mapettar/OGN-Solar-Receiver/images/rpi-gpio-pinout.png

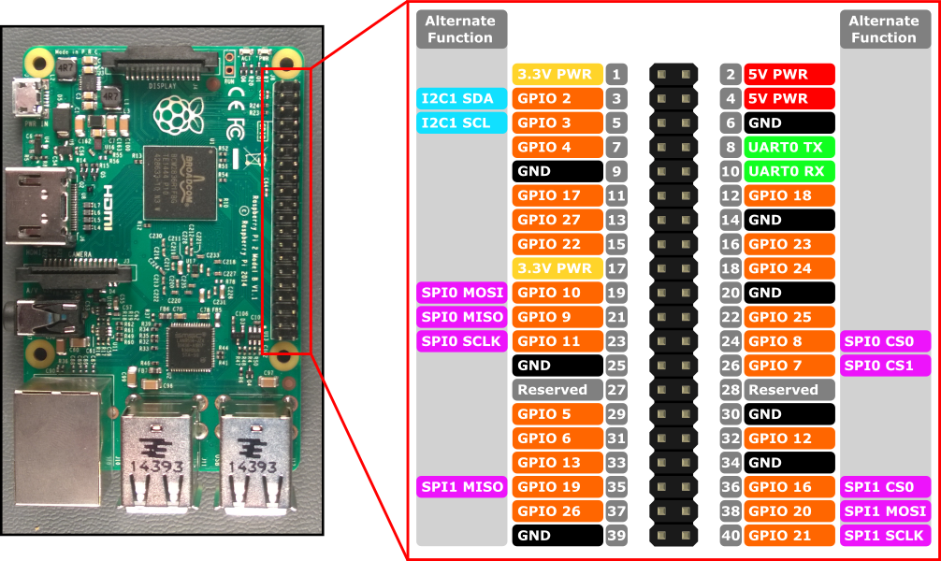
images/rpi-gpio-pinout.png
