mapettar/OGN-Solar-Receiver/src/README.md

# Sorgenti

| Percorso | Dove va | Note |
|---|---|---|
| `attiny/OGN_Attiny_v1_7_3/OGN_Attiny_v1_7_3.ino` | ATtiny85 Digispark (Arduino IDE) | Come la 1.7.2, ma negli ultimi 3 minuti prima del taglio non legge il DS3231 (SCL a massa sveglia la RPi in halt). Da usare con `SCHEDULE=on` (halt a tramonto-90, taglio a tramonto-88) |
| `attiny/OGN_Attiny_v1_7_2/OGN_Attiny_v1_7_2.ino` | ATtiny85 Digispark (Arduino IDE) | Soglie batteria per Li-ion 3S (R1 56k / R2 10k). Per LiFePO4 2S con partitore 20k/10k: `SOGLIA_BATT_MIN 310`, `SOGLIA_BATT_ON 330` |
| `rpi-boot/calc_sunset.py` | `/boot/` sulla RPi | Tramonto, crontab e taglio relè (tetto 19:00 CEST) |
| `rpi-boot/setup_cron.sh` | `/boot/` sulla RPi | Eseguito ad ogni avvio. Imposta `TS_AUTHKEY` con la TUA chiave Tailscale e **non pubblicarla** |
| `rpi-boot/monitor_batteria.py` | `/boot/` sulla RPi | Lettura INA219 (pacco 3S, librerie Adafruit) |
| `rpi-bookworm/ogn-boot-setup.sh` + `.service` | `/usr/local/sbin/` e `/etc/systemd/system/` | Raspberry Pi 3A+ con Bookworm: scrive l'ora sul DS3231 dopo la sincronizzazione e (con `SCHEDULE=on` in `/etc/default/ogn-boot-setup`) imposta lo spegnimento serale |
| `rpi-bookworm/calc_sunset.py` | `/usr/local/sbin/` | Come `rpi-boot/calc_sunset.py` |
| `rpi-bookworm/monitor_batteria.py` | `/usr/local/sbin/` | Lettura INA219 senza librerie (v1.9). Profili `2s-lifepo4` (default) e `3s-liion` con `--pacco`; `--csv` per i log; `--addr 0x41 --carica` per il secondo INA219 in serie al caricabatterie (corrente positiva = entra nel pacco) |
| `rpi-bookworm/install.sh` | scaricato ed eseguito con `sudo` | Installa tutti gli script qui sotto, il comando `stato`, i cron, la rotazione dei log e il journal persistente (v1.6; `--hw-watchdog on` attiva anche il watchdog hardware del chip). Presuppone rtlsdr-ogn già funzionante. Provato su una Zero 2 W con SD nuova |
| `rpi-bookworm/stato_stazione.sh` (comando `stato`) | `/usr/local/sbin/` | Riepilogo mattutino con `[OK]`/`[!!]`: avvio, **rete (indirizzo locale e Tailscale)**, DS3231, ciclo spegnimento/avvio, servizi OGN, **chiavetta RTL-SDR, tentativi falliti e CPU di `ogn-rf`, rete APRS**, alimentazione, batteria, **carica (secondo INA219)**, BME280, disco (v1.13) |
| `rpi-bookworm/stato_web.py` + `ogn-stato-web.service` | `/usr/local/sbin/` e `/etc/systemd/system/` | Opzionali (`install.sh --web on`): pagina HTML con il riepilogo di `stato` sulla porta 8090, solo rete locale/Tailscale |
| `rpi-bookworm/ogn_sim.py` + `ogn-sim.service` | `/usr/local/sbin/` e `/etc/systemd/system/` | Opzionali (`install.sh --sim auto|always`): collegamento a internet via SIM7080G con PPP (accensione del modulo, registrazione LTE-M, `pppd`, ripresa se cade, SIM solo se manca il Wi-Fi); impostazioni in `/etc/default/ogn-sim`; richiede `ppp` e `python3-serial` |
| `rpi-bookworm/sim_at.py` | a mano (non installato) | Strumento per comandi AT al modulo SIM7080G a servizio fermato: diagnosi, comandi liberi, `--segnale` per confrontare le antenne |
| `rpi-bookworm/ogn-rtc-ora.sh` + `.service` | `/usr/local/sbin/` e `/etc/systemd/system/` | Raspberry Pi con DS3231: all'avvio, prima della rete e di `ogn-sim`, mette l'ora del DS3231 nell'orologio di sistema (l'orologio di `fake-hwclock` e' in ritardo di ore). Non fa niente se NTP ha gia' sincronizzato, se il DS3231 manca (Zero 2 W) o ha perso l'ora. Evento `ora dal DS3231` in `ogn-eventi.log` |
| `rpi-bookworm/ogn-usb-watchdog.sh` | `/usr/local/sbin/` | Opzionale (`install.sh --watchdog prova|on`): riavvia la Pi se la chiavetta RTL-SDR manca, o solo i servizi OGN se `ogn-rf` è inattivo; impostazione `WATCHDOG_USB=off|prova|on` in `/etc/default/ogn-boot-setup`; stato v1.9 conta i riavvii |
| `rpi-bookworm/bme280_log.py` | `/usr/local/sbin/` | Temperatura, umidità, pressione e punto di rugiada della scatola in `/boot/bme280.log`; avviso in `ogn-eventi.log` a umidità ≥ 80 % |
| `rpi-bookworm/ds3231_log.sh` | `/usr/local/sbin/` | Una riga al minuto con ora e stato del DS3231 in `/var/log/ds3231.log` (cron) |

Soglie 3S: con il Digispark e il partitore 56k/10k, `SOGLIA_BATT_MIN 310` e `SOGLIA_BATT_ON 340` corrispondono a circa 10,35 V e 11,35 V (misurati; vedi `README.md` nella radice del ramo).

Procedura di installazione e ripristino per la Pi 3A+: `OGN-Comandi-SSH-3A-Bookworm.md`. Per il progetto originale (Pi 4): `OGN-Solar-Receiver-Documentazione_1.6.md` (versione 1.7) e `OGN-Comandi-SSH-Reference.md`.
