mapettar/OGN-Solar-Receiver/images/blocco-interruttore-mosfet.png

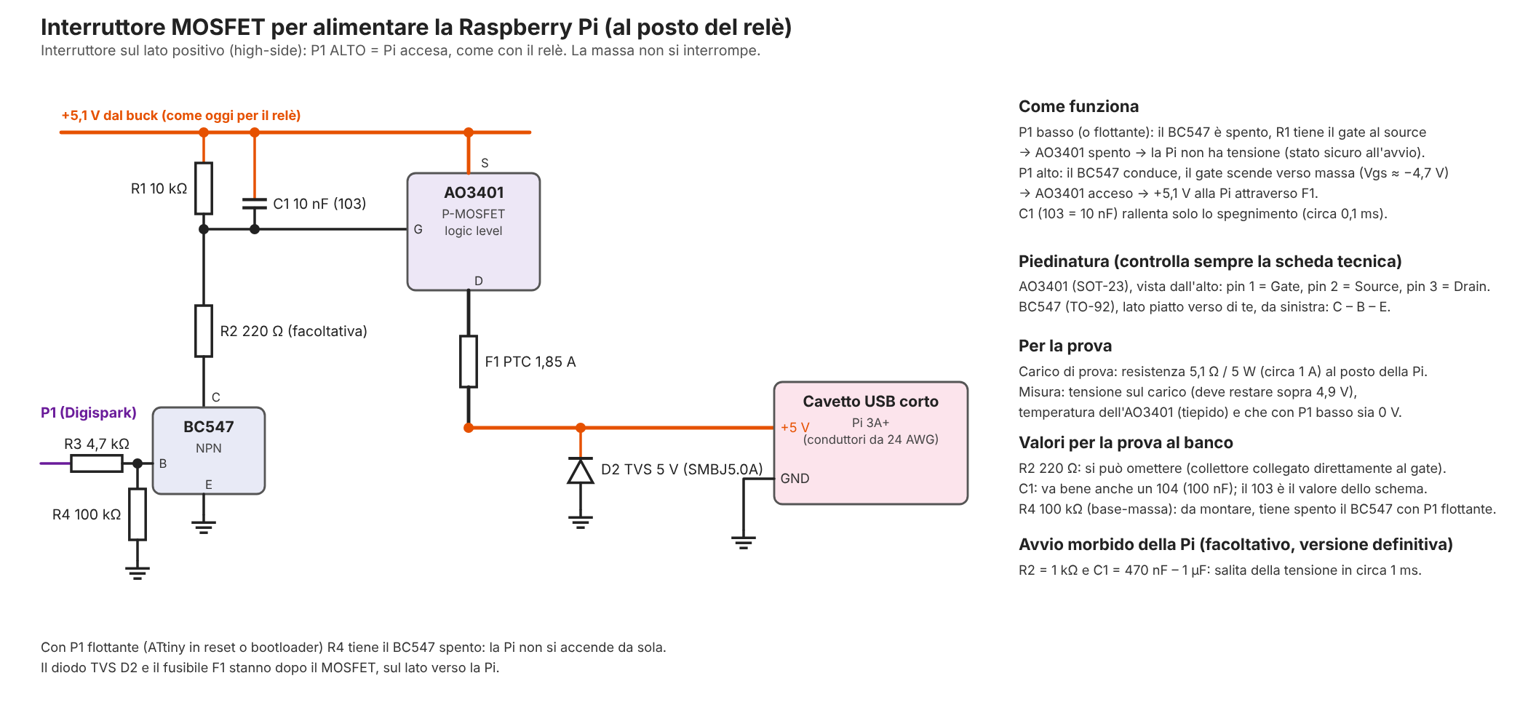
images/blocco-interruttore-mosfet.png
