mapettar/OGN-Solar-Receiver/images/schema-collegamenti-3s.png

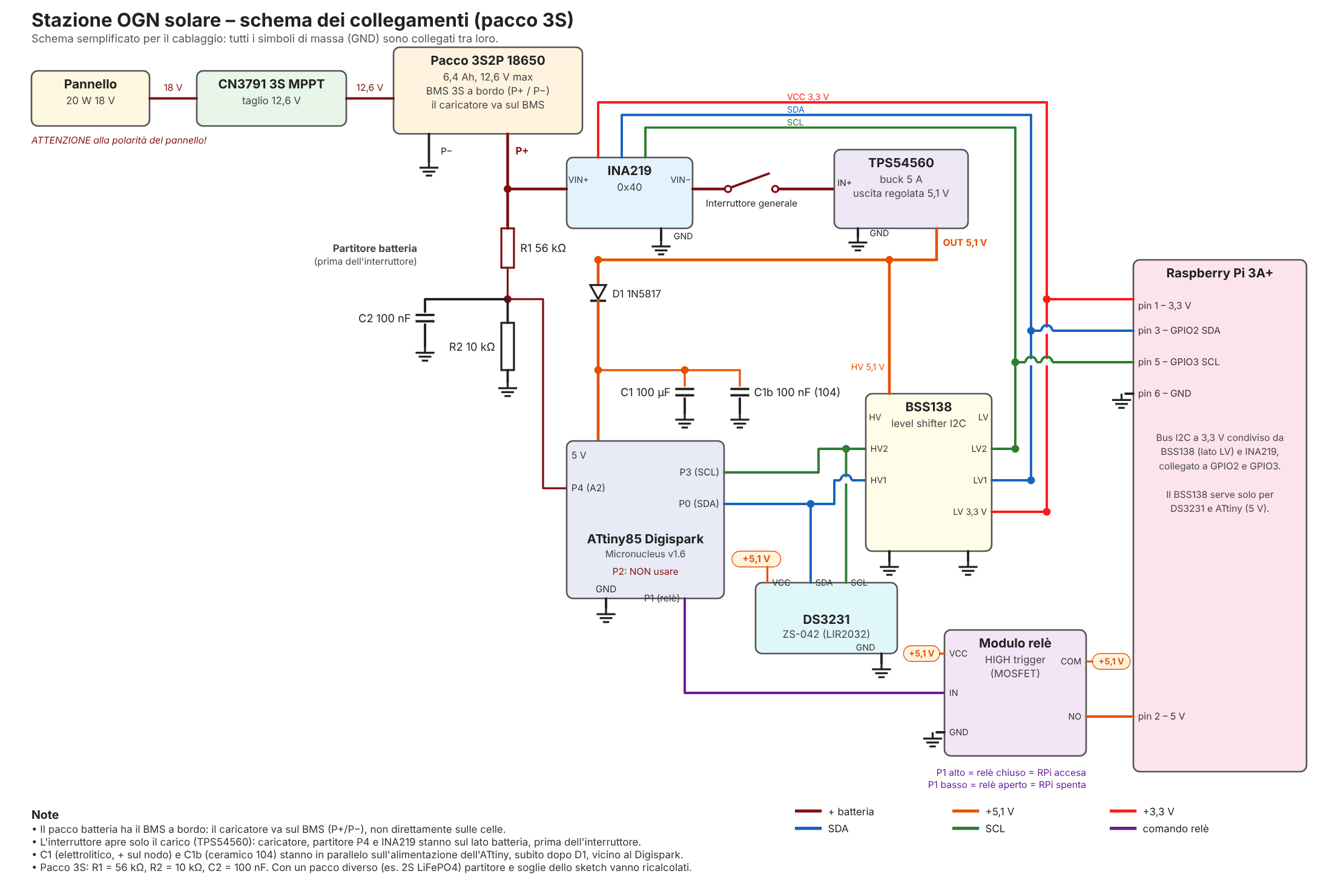
images/schema-collegamenti-3s.png
