mapettar/OGN-Solar-Receiver/(commit log)

2026-08-29 Add files via upload
    Questa guida descrive la realizzazione di una stazione ricevitore OGN (Open Glider Network) autonoma, alimentata da pannello solare e pacco batterie LiFePO4, installabile in zone remote senza rete elettrica né WiFi.
2026-10-20 Aggiunti script di avvio per Raspberry Pi 3A+ (Bookworm), da rivedere
    ogn-boot-setup.sh + .service sostituiscono setup_cron.sh sulla 3A+:
    scrivono l'ora sul DS3231 dopo la sincronizzazione e lanciano calc_sunset.py.
    Nessuna chiave Tailscale, nessuna installazione di pacchetti.
    SCHEDULE=off in /etc/default/ogn-boot-setup disattiva lo spegnimento serale.
    calc_sunset.py e' invariato rispetto a src/rpi-boot. Non ancora provati su hardware.
    Claude-Session: https://claude.ai/code/session_01PcGQ9EdoJzeQdK5e1YwwCo
2026-10-21 ATtiny v1.7.3: silenzio I2C negli ultimi 3 minuti prima del taglio
    Una RPi in halt si risveglia se SCL (GPIO3) viene tirato a massa; le letture
    del DS3231 ogni 30 s la riaccendevano dopo circa 45 s e il rele la tagliava a
    meta avvio. Ora l'ATtiny aspetta l'istante del taglio senza toccare il bus
    (protezione batteria sempre attiva) e apre il rele all'ora esatta.
    Verificato su PC con simulazione del DS3231: giornata normale, tetto 17:00 UTC,
    orologio perso, batteria bassa durante l'attesa, riavvio negli ultimi minuti.
    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
2026-10-21 monitor_batteria.py per Bookworm: INA219 senza librerie, soglie pacco 2S LiFePO4
    Legge /dev/i2c-1 direttamente (nessun pacchetto da installare), calcola la
    corrente dalla tensione sullo shunt (0.1 ohm) e stampa lo stato con soglie 2S.
    Opzione --csv per i log. README: aggiunti gli script di rpi-bookworm.
    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
2026-10-21 monitor_batteria.py: profili di pacco 2S LiFePO4 e 3S Li-ion
    Selezione con --pacco o variabile OGN_PACCO (default 2s-lifepo4), cosi lo stesso
    script serve la stazione attuale e quella con il pacco 3S.
    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
2026-10-21 Guida comandi SSH per la 3A+ con Bookworm
    Sostituisce la guida v1.7 per la nuova stazione: servizi systemd, ogn-boot-setup,
    SCHEDULE, DS3231, INA219 con profili 2S/3S, soglie ATtiny, backup immagine.
    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
2026-10-22 ogn-boot-setup v1.1: controllo di sincronizzazione vero (ntpq) al posto di NTPSynchronized
    Con ntpd attivo, timedatectl poteva dire 'synchronized: yes' con l'ora vecchia di
    fake-hwclock: lo script scriveva quell'ora sul DS3231 a ogni avvio e l'ATtiny tagliava
    il rele dopo ~2 minuti, in ciclo. Ora si scrive solo con un server scelto da ntpd
    (riga '*' in ntpq -pn) o con il file di timesyncd; altrimenti il DS3231 non si tocca.
    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
2026-10-22 Sketch di test da banco per il PCB: relè fisso, livelli SDA/SCL e lettura DS3231 con codici a lampeggi
    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
2026-10-25 Pinout GPIO Raspberry Pi nella documentazione
    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
2026-10-25 Schema e documentazione: rimossa R3 (pull-up 470 ohm), aggiunto C1b 100 nF in parallelo a C1
    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
2026-10-25 Documentazione: tolto il riferimento al pull-up 470 ohm
    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
2026-10-26 Schema: +3,3 V in rosso, +batteria in rosso scuro (non confondibile con SCL)
    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
2026-10-27 Schema del blocco interruttore MOSFET (BC547 + AO3401, PTC, TVS) al posto del relè
    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
2026-10-27 Schema interruttore MOSFET: valori corretti (C1 103/104, R2 facoltativa, avvio morbido)
    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
2026-10-29 Aggiunge bme280_log.py v1.0: log temperatura/umidita' e avviso umidita' alta
    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
2026-10-29 stato_stazione.sh v1.1: ora UTC di avvio corretta, ignora INA219 senza batteria
    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
2026-10-29 stato_stazione.sh v1.2: INA219 non collegato non stampa il traceback
    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
2026-10-31 Ramo 3A+: README, stato v1.4 con controllo della chiavetta RTL-SDR, guida aggiornata
    - README.md nella radice del ramo: differenze rispetto a main (Pi 3A+, pacco 3S,
    MOSFET, Mini560, sketch 1.7.3, CR2032), soglie reali della batteria (10,35 / 11,35 V),
    consumo misurato (5,3 W con chiavetta) e dimensionamento del pannello (stima), limiti noti.
    - stato_stazione.sh v1.4: nuova sezione "Ricevitore": chiavetta in lsusb, errori USB nel
    kernel, tentativi falliti di ogn-rf, CPU di ogn-rf, collegamento APRS. Un ogn-rf in
    attesa senza chiavetta non da' piu' "TUTTO OK" (caso del 31 ott 2026).
    - install.sh v1.1: installa usbutils se manca lsusb.
    - OGN-Comandi-SSH-3A-Bookworm.md: sezioni 10 (Blue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
2026-10-31 stato v1.5: episodio concluso vs in corso, CPU istantanea di ogn-rf, prima lettura DS3231 fallita
    Dalla prova reale con chiavetta scollegata e ricollegata sulla Zero 2W:
    - i tentativi falliti di ogn-rf ("Cannot open device") dicono se sono in corso (ultimo
    entro 90 s) o se l'episodio e' concluso, con l'ora dell'ultimo; pochi tentativi
    all'accensione sono solo informativi;
    - la CPU di ogn-rf e' misurata sul momento (1 s) e avvisa se e' sotto il 15% con la
    chiavetta presente e almeno 5 minuti di funzionamento;
    - il collegamento APRS e' etichettato "rete": non prova che si riceva;
    - una prima lettura fallita del DS3231 non conta piu' come "ora presente".
    install.sh v1.2: messaggio finale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
2026-10-31 stato v1.5: testo della CPU di ogn-rf corretto (varia da 40% a oltre 100%, avviso sotto 15%)
    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
2026-10-31 Secondo INA219 (0x41) per la carica: monitor_batteria v1.9, stato v1.6, install v1.3, documenti
    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
2026-11-01 Pagina di stato HTML opzionale (porta 8090): stato_web.py, servizio systemd, install.sh --web
    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
2026-11-01 stato v1.8: modalita' banco di prova e stato della carica con ultime letture
    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
2026-11-01 stato v1.10: PATH con /usr/sbin (la pagina web da cron non trovava i2cget); stesso fix in watchdog e stato_web
    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
2026-11-03 watchdog v1.2: gradino 'solo servizi' se ogn-rf e' inattivo con la chiavetta presente; riavvio Pi solo se manca o dopo i riavvii servizi esauriti
    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
2026-11-04 stato v1.12: avviso se il DS3231 ha perso l'ora negli ultimi 3 giorni
    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
2026-11-04 stato v1.12.1: l'ultimo evento 'ora persa' e' il piu' recente
    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
2026-11-09 install.sh v1.6: --hw-watchdog on|off (watchdog hardware 15 s) e journal persistente
    La Zero 2W si e' bloccata per ore il 9 nov 2026 senza lasciare tracce (journal volatile);
    il watchdog USB da cron non copre un blocco totale.
    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
2026-11-12 ogn_sim.py v1.1: la strada predefinita via ppp0 la imposta il servizio (metrica 700 col Wi-Fi buono, 50 senza); peers con noipv6
    pppd con defaultroute non sostituisce una strada gia' presente ('not replacing default route to wlan0'), quindi
    con il Wi-Fi collegato ma senza internet la SIM non sarebbe stata usata.
    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
2026-11-12 ogn_sim.py v1.2: uscita dalla modalita' dati (+++ e ATH) dopo la caduta di pppd; LCP echo ogni 60 s x 5
    12 nov 2026: pppd e' caduto per mancanza di risposte LCP e il modulo, rimasto in modalita' dati,
    ignorava i comandi AT: il servizio lo credeva spento e mandava inutili impulsi su PWRKEY.
    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
2026-11-13 Documentazione SIM7080G: accensione automatica, SIM_PLMN, sim_at.py --segnale, prove di segnale
    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
2026-11-13 ogn-rtc-ora: ora del DS3231 nell'orologio di sistema all'avvio, prima della rete e di ogn-sim (install.sh 1.8)
    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
2026-11-13 ogn_sim v1.6: cancella la strada ppp0 con la metrica vecchia quando cambia
    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
